MechanicTony/AOG_CAN_Teensy4.1/Teensy PCB/PCB Image.png

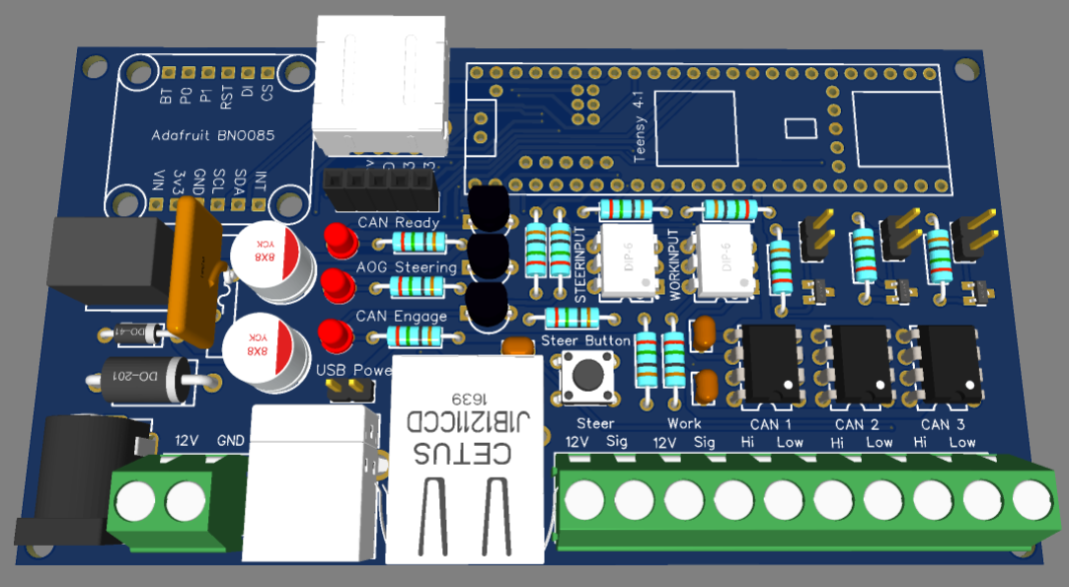
Teensy PCB/PCB Image.png
