MechanicTony/AOG_CAN_Teensy4.1/Teensy PCB/ReadMe.md

PCB just to make testing / using the Teensy4.1 a little easyier. The parts list is most parts needed but you will have to check and order the parts you need.

Ethernet connector needs to be J1B1211CCD and only stock seems to be on AliExpress
