MechanicTony/AOG_CAN_Teensy4.1/Teensy PCB/Schematic_Teensy 4.1 CAN Ver2_2023-02-23.png

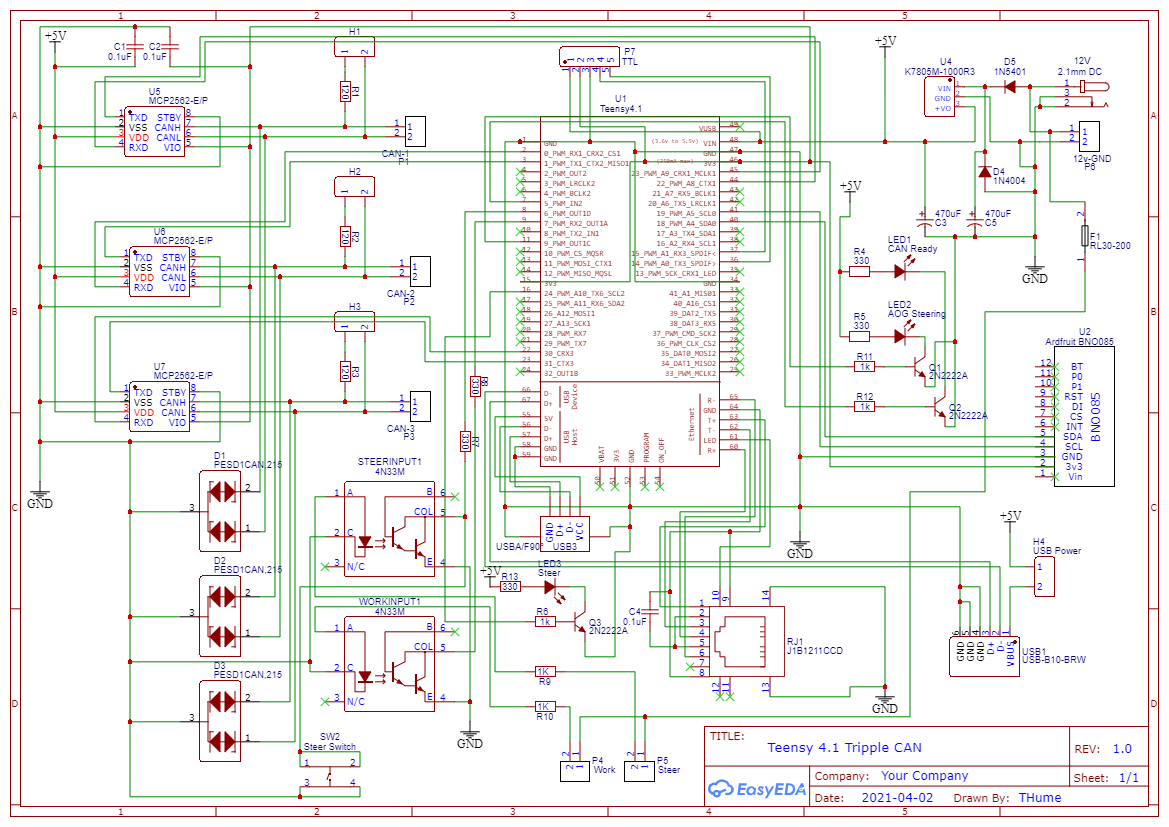
Teensy PCB/Schematic_Teensy 4.1 CAN Ver2_2023-02-23.png
