MechanicTony/AOG_CAN_Teensy4.1/(threads)

Thread 1 (2022-05-21):

CMPS14 Heading error

PeterSwell1, 2022-05-21:
Hi,
In the IMU timed loop there is an error in the CMPS14 reading of the header data:

was

         //the heading x10
        data[5] = Wire.read();
        data[6] = Wire.read();

should be

        //the heading x10
        data[6] = Wire.read();
        data[5] = Wire.read();

I've never used github so i don't know how to do pull requests etc.

Best wishes
Pete

Closed 2023-09-10.
