MechanicTony/AOG_CAN_Teensy4.1/(commit log)

2021-10-09 Update Teensy LCSC Parts.csv
    [Teensy LCSC Parts.csv]
2022-03-01 Added Brand 7 AgOpenGPS
    Added support for remote CAN/PWM module. (So we can turn standard PWM valve into a CAN controlled valve with pressure sensor & wheel angle sensor) this will simplify and shorten wiring.
    [AutosteerPID.ino, Autosteer_AOGv5_Teensy4.1UDP_SteerReadyCAN.ino, CAN_All_Brands.ino, CAN_Service_Tool.ino]
2022-03-15 Fendt & BNO
    Fix missing else in Fendt counts per deg, Change BNO back to gameRotation mode.
    [Autosteer_AOGv5_Teensy4.1UDP_SteerReadyCAN.ino]
2022-07-02 Revert "Merge branch 'Onboard-GPS'"
    This reverts commit c528fb0bd321bf4954f4ed1111ea38da6506b7d4, reversing
    changes made to eb2c5d9e84167172f12a26d7e23709f678d6a3c7.
    [AutosteerRelays.ino, Autosteer_AOGv5_Teensy4.1UDP_SteerReadyCAN.ino, CAN_All_Brands.ino, GPS.ino, zHandlers.ino]
2022-07-02 Update IMU settings
2022-07-02 Fix JCB filters
2022-07-09 Add hitch to pressure reading display
    For ISOBUS work switch.
2022-12-14 Change label buttons to suit CAN options.
2022-12-29 CPU Speed, Update to suit new version AOG
    CPU Speed = 150mhz (10deg cooler CPU). Change how setting are read from AgOpenGPS, MinPWM is hard coded to 1 and now the MinPWM setting from AOG is the LowPWM in Teensy.
2022-12-31 Move IMU stuff ready for Panda
2023-01-12 Add hardcoded WAS calibration
2023-01-28 Update CAN_All_Brands.ino
    cnh add 2 engage button and hitch message for work switch
2023-01-29 Update AgOpenGPS for CANBUS
2023-02-03 Fix Scan & Hello for v5.7.1
    [Autosteer_AOGv5_Teensy4.1UDP_SteerReadyCAN.ino]
2023-02-18 Add swapping IMU axis from AgOpen
    [Autosteer_AOGv5_Teensy4.1UDP_SteerReadyCAN.ino, GPS.ino]
2023-02-25 Fix j1939 encoder and decoder
    [j1939.ino]
2023-03-04 Remove IMU code, must use Panda with BNO08x on PCB
2023-03-05 Add send 1hz messages
2023-03-05 Fix missing brakets
2023-03-06 Fix some GPS to ISOBUS parts
    [Autosteer_AOGv5_Teensy4.1UDP_SteerReadyCAN.ino, CAN_All_Brands.ino, j1939.ino, zHandlers.ino]
2023-03-18 Update parts list
    [Teensy LCSC Parts.csv, Teensy LCSC Parts.xlsx]
2023-09-11 Shift Mccormick to filter number 2
2024-05-04 Fix Brand 9 Reverse
    [Autosteer_AOGv5_Teensy4.1UDP_SteerReadyCAN.ino]
